KKoovalsky/Jeff/README.md

# **J**ungles' Guitar **Eff**ect :guitar: :musical_score: :notes: 

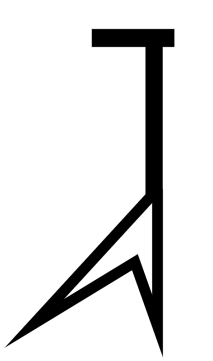
[picture p1: docs/diagrams/jeff_logo_white_background_small.drawio.png]
Jeff Logo


[Project main page](https://kkoovalsky.github.io/Jeff/)

The repository contains both the [hardware](hardware) and the [firmware](firmware). Check out the corresponding
directories for details.
