KKoovalsky/Jeff/firmware/scripts/hard_clipped_sine_dfts/hard_clipped_sine_dft_4000_100000_0.1_5.png

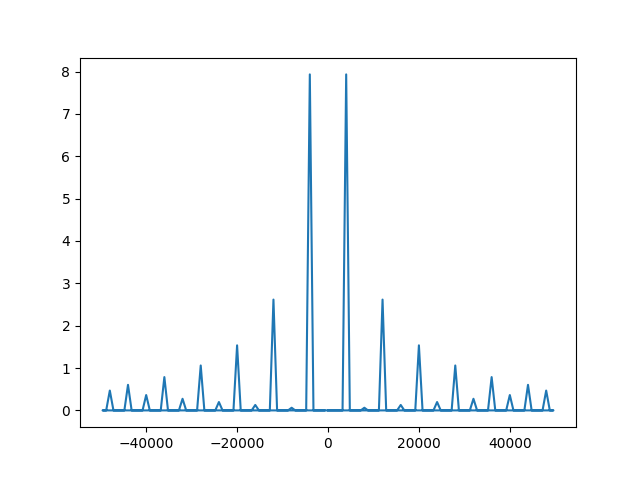
firmware/scripts/hard_clipped_sine_dfts/hard_clipped_sine_dft_4000_100000_0.1_5.png
