KKoovalsky/Jeff/firmware/scripts/hard_clipped_sine_dfts/hard_clipped_sine_dft_8000_100000_0.8_5.png

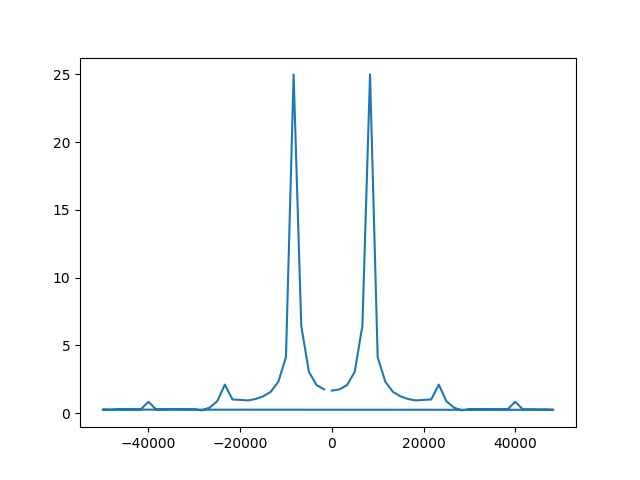
firmware/scripts/hard_clipped_sine_dfts/hard_clipped_sine_dft_8000_100000_0.8_5.png
