KKoovalsky/Jeff/firmware/scripts/hard_clipped_sine_dfts/hard_clipped_sine_dft_16000_100000_0.4_5.png

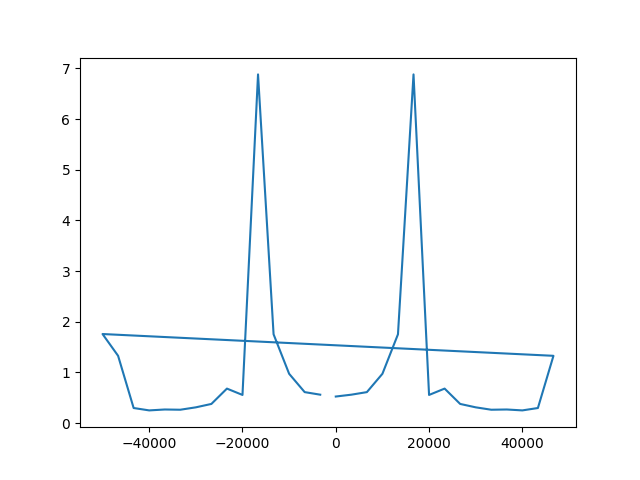
firmware/scripts/hard_clipped_sine_dfts/hard_clipped_sine_dft_16000_100000_0.4_5.png
