KKoovalsky/Jeff/firmware/device/cube/Jeff/Jeff.ioc

Mcu.UserName=STM32L432KCUx
PA0.GPIO_Label=ADC1_IN5_A0
PA0.Signal=ADCx_IN5
PA12.GPIO_Label=BUTTON0
PA12.Signal=GPIO_Input
PA2.GPIO_Label=LPUART1_TX_A7
PA2.Signal=LPUART1_TX
PA3.Signal=LPUART1_RX
PA4.GPIO_Label=DAC1_OUT1_A3
PA4.Signal=COMP_DAC11_group
PA6.GPIO_Label=TIM16_CH1_A5
PA6.Signal=S_TIM16_CH1
