KKoovalsky/Jeff/(commit log)

2021-12-06 Implement hard clipping and showing samples
2021-12-07 Print logs
2021-12-07 Move samples to 'samples' dir
2021-12-07 Generate code for STM32L432KC
    This is basic setup with:
    * FreeRTOS enabled
    * Debug LPUART enabled
    * 80 MHz clock
2021-12-07 Copy initial device build from Aura project
    Aura can be found here: https://github.com/KKoovalsky/AuraFW
2021-12-09 Add empty ThreadedAudioSampler
2021-12-09 Add outline test file for ThreadedAudioSampler
2021-12-10 Generate code with ADC and disabled LPUART Init call
    The LPUART init call was called inside main(). We call this on our own
    so there is no need to call it from the main().
2021-12-10 Add body of the basic test and set handler
    This tests doesn't work but compiles
    [threaded_audio_sampler.cpp, threaded_audio_sampler.hpp]
2021-12-10 Increase ADC conversion time
2021-12-10 Compile the new adc.c file
    It contains code related to ADC handling.
2021-12-10 Use LL library for the ADC
2021-12-10 Do not generate ADC1 interrupt handler - add own
    We will keep the interrupt handler in the same place it is used.
2021-12-13 Compile LL library files needed by adc.c
2021-12-13 Add base ThreadedAudioSampler Error
    The inheritors shall throw Errors which inherit from that Error.
2021-12-13 Implement ThreadedAudioSampler::Error
    The error (exception) message, passed to the constructor, will be
    prefixed with the name of the module.
    [threaded_audio_sampler.cpp, threaded_audio_sampler.hpp]
2021-12-13 Initially implement ADC1 interrupt handler
    This is taken from:
    STM32Cube_FW_L4_V1.17.0/Projects/NUCLEO-L496ZG/Examples_LL/ADC/ADC_SingleConversion_TriggerSW_IT
    I changed the code from the interupt handler a little bit, to expect End
    Of Sequence flag to be set, since this is how I configured the SW via
    CubeMX.
    There is a global static function handler added, called
    adc1_interrupt_handler, that can be used by the singleton to run some
    custom code. The custom code is called from the interrupt if it is
    initialized.
2021-12-13 Calibrate, activate and enable ADC
    This is a bit refactored code from the example:
    STM32Cube_FW_L4_V1.17.0/Projects/NUCLEO-L496ZG/Examples_LL/ADC/ADC_ContinuousConversion_TriggerSW_Init
    This is not yet tested.
    After running this code the ADC shall perform continuous conversions.
2021-12-13 Implement handling new sample
    The handler will be used when a new sample arrives. It converts the new
    sample and calls the external handler, set by
    set_on_sample_received_handler().
    The handler converts a raw sample according to voltage levels.
2021-12-13 Handle new samples from thread
    An Active object is used when new samples arrive. The
    adc1_interrupt_handler is called to push new raw sample to the message
    pump. Then the Active object will call the handler passed to it when
    constructing. The handler calls handle_new_sample().
    This makes the ISR handler possibly short and all the other handling is
    done from the task context.
    [threaded_audio_sampler.cpp, threaded_audio_sampler.hpp]
2021-12-14 Increase global FreeRTOS heap, default task stack size
    Because of the too low stack size of the default task the app crashed
    when switching context.
    [Jeff.ioc]
2021-12-14 Change Cube setting to wait for EOC instead of EOS
    This doesn't affect code, what is weird.
    [Jeff.ioc]
2021-12-14 Delay after ADC calibration
    If Enable function is called immediately after calibration, then we
    shall delay, according to the documentation and the examples, e.g.:
    STM32Cube_FW_L4_V1.17.0/Projects/NUCLEO-L496ZG/Examples_LL/ADC/ADC_ContinuousConversion_TriggerSW_Init/Src/main.c
    line 562
2021-12-14 Enable End Of Conversion ADC interrupt
2021-12-14 Implement test for ADC sampling frequency accuracy
    This test fails at this moment.
2021-12-14 Use fixed inserting to queue from ISR
2021-12-14 Add TODOs for ADC cleanup
2021-12-15 Handle samples in batches
    This introduces a little bit of coupling. Because of that the samples
    come quite frequently, we perform such scenario:
    1. ADC1 interrupt sends a sample to a queue.
    2. Queue is unlocked so a context switch may happen.
    3. Corresponding handler is called for a new sample.
    For each new sample a context switch may happen, what takes a lots of
    time. This means that we have to decrease the number of context
    switches. This is done by supplying the samples to the handler in
    batches. I guess we can use ADC with DMA for that.
    By introducing coupling I mean that the interface is forced to be
    defined basing on the details. On the other hand it is OK to define such
    an interfac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
2021-12-17 Generate code with DMA connected to ADC
    This enables DMA working with ADC from CubeMX. This is not utilized yet.
2021-12-17 Disable ADC interrupt
    We use batch DMA interrupt instead.
2021-12-17 Invoke batch handler on DMA interrupt
    This turns from using ADC interrupt on single sample received to use DMA
    interrupt, which is invoked when a batch of samples is sampled.
    The DMA is configured to store samples into internal raw_sample_buffer.
    The DMA interrupt is configured to trigger when the entire buffer is
    filled. Then send_new_batch_of_samples_to_active() is invoked from the
    interrupt handler. The interrupt handler can access this private method
    because there is a singleton_pointer. singleton_pointer is a pointer to
    the instance created with a constructor. Only one instance of
    ThreadedAudioSampler can be created at a time. The DMA interrupt handler
    is friend to the ThreadedAudioSam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
2021-12-17 Add custom HardFault_Handler
    By inspecting 'frame' pointer from GDB, one can find out some details
    about the hard fault.
    Currently I'm struggling with HardFaults generated when sending objects
    from the DMA interrupt to the Active.
2021-12-17 Increase heap size by 4kB
    I couldn't increase more, because in the Debug build the app crashed at
    the beginning. This might be related to overlapping sections in RAM.
    [Jeff.ioc]
2021-12-17 Increase thread stack size
    Just to be sure.
2021-12-17 Implement tearing down ThreadedAudioSampler
2021-12-17 Decrease test thread stack size
    The stack size is passed in words, not in bytes, as I thought before. 4
    kB of stack size is much and enough.
2021-12-17 Fix ADC clock to be more or less 48 kHz
    [Jeff.ioc]
2021-12-17 Fix counting received samples from the test
2021-12-17 Switch to custom event-based synchronization
    The ThreadedAudioSampler used jungles::freertos::active before. This is
    wrong, because it used FreeRTOS ISR API to quit the thread.
    Active is good when using messaging between multiple threads, or when
    deputing job for later and splitting the tasks. Here we use DMA with
    specific timely requirements. Active introduces lots of overhead for
    this solution. Custom Event-based approach is much better here.
    The new approach works in such a way:
    1. DMA will trigger interrupt on half transfer and full transfer.
    2. The raw buffer is twice the size of the converted sample buffer.
    3. When half transfer IT occurs the first half of the raw sample
    buffer is t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
    [threaded_audio_sampler.cpp, threaded_audio_sampler.hpp]
2021-12-17 Remove non-testable test
    We can't really test the stability of the sampling frequency, because
    we should test here whether the clock is stable.
    The samples come for sure not in orderly matter because we use RTOS,
    which may affect timings.
    This doesn't mean that the samples received have jitter because of
    RTOS. We simply perform calculation non-deterministically.
2021-12-18 Fix batch of samples to be std::vector<int>
    This fixes the AudioSampler Interface to expect any type in the handler.
    This is much better because the type used may be anything: a pair of
    iterators, a const reference to some container.
    We use std::vector<int> passed to the handler by value.
    This is much better, because we can easily move around the vector.
    [threaded_audio_sampler.cpp, threaded_audio_sampler.hpp]
2021-12-19 Delay before disabling
    This is needed, because in the Release build this has failed.
    The error was that the test:
    test_multiple_instances_can_be_run_one_after_another() failed (hanged),
    because the previous instance was not properly stopped.
    After the first instance was created, the second instance didn't
    generate any interrupt, due to inproper disabling of ADC.
    [threaded_audio_sampler.cpp]
2021-12-19 Generate code for TIM6 triggered ADC
    With this commit we generated code for ADC triggered by the external
    TIM6 Update Event. The frequency of Update Events is set to more or less
    44100 Hz:
    80000000 / 907 / 2 = 44101,43329658213891951488
    Thanks to it the TIM6 will drive sampling frequency. It was impossible
    to have such a frequency using only ADC settings.
2021-12-19 Start the TIM6 according to schedule
    This will drive ADC using external TIM6. The sampling frequency will be
    around 44.1 kHz.
2021-12-19 Implement Singleton properly
    When the second instance of ThreadedAudioSampler is created it throws.
    There was an error, because the jungles::freertos::thread had a bug,
    which showed up when the thread was destructed without being started.
    This is fixed with the new version of the library.
2021-12-19 Alias malloc() and free() to FreeRTOS equivalents
    To make it thread-safe.
2021-12-20 Generate code: GPIO HAL to LL; support button
    We have switched for GPIO from HAL to LL, because basically we would
    like to switch from HAL to LL for any component.
    This switch was by the way for generation of the code for an input pin
    which will be used for input button.
2021-12-20 Initial implementation of button handling
    This implements and tests Button, in semi-automatic way (the developer
    is asked to press the button).
    I have soldered a debouncing hardware from this blog post:
    https://hackaday.com/2015/12/09/embed-with-elliot-debounce-your-noisy-buttons-part-i/
    Exactly, this circuit:
    https://hackaday.com/wp-content/uploads/2015/11/debounce-sch.png
    The first tests passes.
    Others are not yet implemented.
2021-12-20 Fix button press detect when not released
    We didn't wait for the button to be released and because of that the
    tests have passed quickly after first button press. The first button
    press was detected as multiple. This is because we didn't wait for the
    button release.
    The second test is implemented and passes.
    [button.cpp]
2022-01-04 Switch to float for samples
    Since this commit the samples will be in range <-1;1> instead of
    <INT_MIN;INT_MAX>. This is easier for computation and prevents from
    overflows.
    [threaded_audio_sampler.cpp, threaded_audio_sampler.hpp]
2022-01-04 Test input sine sampling
    This adds semi-automatic tests which test whether input sine wave is
    properly sampled. The tests check against 100 Hz, 1 kHz, 10 kHz and 20
    kHz.
    The tests work in such a way that it is expected to provide the
    corresponding sine wave to the input pin PA0 (A0 STM32L432KC Nucleo
    pin). The amplitude shall be 1.6V, DC offset 1.6V. Then the sine wave is
    compared against a pattern and cross correlation function is calculated.
    At this stage the tests are quite unstable. Sometimes they show that the
    correlation factor is almost 1 (or -1). But every second test it shows
    much smaller value. It may depend on the function generator I use, which
    is so-so stable (GW GFG-8019G). E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
2022-01-07 Switch to FFT based harmonic comparison
    We abandon cross-correlation function based comparison, because it is
    better for populations and sets, not good for signals. We use FFT
    instead.
    Because of that the Q DSP library (used for generating sine wave which
    was the signal pattern) and CPP Utils library (implementing
    cross-correlation function) are no longer needed.
    The comparison works like that:
    * Compute FTT and harmonic magnitudes.
    * For the specific harmonic find an index in the FFT.
    * Get power of the harmonic, by adding the magnitude of the
    corresponding FFT sample and the magnitude of the FFT samples on the
    left and right (get_sum_around())
    * Get power of the noise, which is the sum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
2022-01-11 Add initial DAC implementation
    It doesn't work yet, but compiles. We will use it to synthesize the
    sampled signal with applied guitar effect.
2022-01-11 Generate code for DAC with CubeMX
    Low-level code with DAC is enabled, where:
    * DMA is enabled to provide buffered data to DAC
    * No DMA ISR routine is generated - to be defined.
    * TIM6 is used to sample the data. The same Timer is used for ADC, so it
    means that the input frequency will be the same as output frequency.
2022-01-21 Add interface and implementer for sampling timer
    This will be used by both the ADC and DAC, to generate the same sampling
    frequency in both modules. The timer will be have to implement an use
    count, similar to "reference count", when using start() and stop(). This
    is a must, because otherwise the timer could be stopped when it is still
    needed by the other module.
    The ADC doesn't use the interface yet, thus it is a TODO.
2022-01-21 Implement basic audio DAC
    This only implements the module to pass the tests in
    test_audio_dac_basic.cpp. The sine wave generation is not yet
    implemented.
    The implementation is a copy of the implementation within the
    ThreadedAudioSampler. The principle of operation is similar. We use DMA
    to update the underlying raw buffer from the thread code. The raw buffer
    is twice the size of the buffer with samples, which are obtained using
    the Handler. After each half of the buffer transferred using DMA to DAC,
    we ask the Handler for new samples and copy it to the just-updated half,
    to give time for conversion, thus preventing from overwritting. This is
    hard-real-time task, so the conversion should be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
2022-01-25 Switch to pointer to array for compat. with DAC
    Since the buffer will be passed from the sampler to the DAC, then we
    need to have the same types for both modules.
2022-01-25 Get rid of finisher semaphore and use join() instead
    The semaphore was not needed because we can simply use join() on the
    thread.
2022-01-25 Use SamplingTriggerTimer within the audio sampler
    The same timer is used by the DAC and the audio sampler to provide
    synchronization. This is why we use the same interface in both modules.
2022-01-26 Implement and test AudioChain
    The AudioChain represents the chain of the signal:
    sampler -> guitar effect -> DAC
    Thanks to this logic module, we can develop those three modules in
    separation.
2022-01-27 Test input signal is outputted with no change
    I have tested it and I can see the output being the duplicate of the
    input. The accuracy is not so high. The output has shape of stairs,
    because of digital DAC.
    The setup is:
    - connect function generator to A0, generate sine wave, DC offset 1.6V
    amplitude 1.6V
    - connect oscilloscope to A3, and see the duplicated output signal
2022-02-01 Initial impl of BasicWindowedDistortionWithMemory
    This is Distortion implementation by windows, with memory, which stores
    the previous batch of samples. It works in such a way, that for each
    sample a absolute maximum is found in a window. If current sample has
    i'th index and window size is W then the window spans from sample
    'i - W' excluded to 'i' included. For that window a threshold is
    calculated basing on the absolute maximum value. If the current sample's
    absolute value is above the threshold, then it is clamped to the
    [- window threshold] or [+ window threshold].
    The implementation is initial because it is not fully tested and some
    improvements and refactorings will be made.
2022-02-01 Switch to data driven tests
    There will be multiple cases, so it is better to switch to data driven
    tests.
2022-02-02 Add benchmark for distortion
    It will be used like that:
    ./tests/host/jeff_host_tests [!benchmark]
    I will apply refactoring to the guitar effect, thus the benchmark will
    be really helpful in such case.
2022-02-02 Optimize distortion
    The optimization introduces:
    1. Calculating absolute values once for each batch...
    2. ...Then we can store the previous batch's absolute values, and not
    recalculate it.
    Previously, absolute values were calculated each time an absolute maximum
    was searched. Now we use one more container (so regarding the data,
    there is no optimization, but the opposite - we will use more data) to
    store the calculated absolute values for the current batch and then
    we store it as the previous absolute values for the next call to
    apply().
    According to benchmarks, this improves significantly:
    -------------------------------------------------------------------------------
    Basic windo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
2022-02-02 Pretty print benchmark
2022-02-07 Add global audio chain configuration
    This will be used by the ADC and DAC implementers, and by GuitarEffect
    implementers, since the type compatibility between the implementers
    (interfaces as source) is a must.
2022-02-07 Use global BatchOfSamples
    Since all the implementers have to be type compatible, then it's good to
    have a single file with the current configuration of the audio chain.
    The implementers, I have mentioned, are all the interfaces from the
    AudioChain.
    We simplify the usage of BatchOfSamples to treat is as a container.
2022-02-07 Add JeffAppWrapper which wraps the app
    This is a wrapper which allows to create apps only by inserting the
    guitar effect, thus applying DRY by not instatiating DAC and ADC
    implementers for each application.
2022-02-07 UNTESTED: Add distortion app
    This is basic distortion app which is not tested at this stage.
2022-02-07 Switch to JeffAppWrapper in the audio chain
2022-02-07 Make distortion_app a device executable
2022-02-08 Generate code for filter clock generation
    The post-DAC filter and the anti-aliasing filter are SCF filters. They
    need clock at one of the inputs to set the cutoff frequency, which is
    100:1. Thus to set 20 kHz pass-band we have to generate 2 MHz clock.
    This generates code which allows to generate clock at PA6 pin, using
    TIM16 PWM. This is not used, thus not tested yet.
2022-02-08 Decrease Tick interrupt priority
    After using TIM16 CubeMX automatically changed the interrupt priority. I
    don't know yet what is the impact of it.
2022-02-08 Not working: Add filter cutoff frequency setter clock
    This doesn't work yet. This adds new test which checks whether the class
    is able to produce the clock. At this stage it is not.
    I will investigate that further.
    I checked the code agains the example:
    STM32Cube_FW_L4_V1.17.0/Projects/NUCLEO-L496ZG/Examples_LL/TIM/TIM_PWMOutput_Init
    and it seems almost identical. The problem may lie in the SB16/SB18
    jumpers on the nucleo board.
    [filter_cutoff_setter_clock.cpp, filter_cutoff_setter_clock.hpp]
2022-02-08 Fix clock to generate 2 Mhz, 50% duty cycle
    Previous configuration was wrong. It gave me around 2,6 MHz frequency
    and 33% duty cycle.
    [Jeff.ioc]
2022-02-08 Fix clock generation by enabling outputs
    Without the call to *EnableAllOutputs() no output was generated at the
    pin A5. This fixes 2MHz clock generation.
    [filter_cutoff_setter_clock.cpp]
2022-02-08 Document filter cutoff setter clock test
2022-02-10 Run filter cutoff frequency setter from any app
    This enables running the filter cutoff frequency setter from any app
    that uses the wrapper.
2022-02-10 Add layout for benchmark timer
    This are shallow tests and implementation for future filling (doesn't
    work yet).
2022-02-10 Generate code with CubeMX for benchmark timer TIM7
    We will use TIM7 to count microseconds for the benchmark timer.
2022-02-10 Implement benchmark timer
2022-02-10 Document benchmark timer tests
2022-02-11 Fix overflow calculation for benchmark_timer
    The problems were that:
    1. The max_hardware_timer_counter_value was initialized before call to
    MX_TIM7_Init, where the AutoReload register is initialized, thus we
    initialized max_hardware_timer_counter_value with 0 always. At the stage
    of initializer list being called, the TIM7 was not initialized yet.
    2. The actual "period" of the timer is AutoReload + 1, because the timer
    counts from 0.
2022-02-11 Benchmark distortion on the device
    This adds test which checks how much time does it take for
    BasicWindowedDistortionWithMemory to apply the effect.
    Results are:
    INFO: Distortion apply() execution times: max: 572, min: 564, average: 567.019
    Which means that, taking into consideration that we have window with 64
    samples converted by ADC (or DAC) with 44100 Hz frequency, gives around
    1450 us to sample a window. It means that we have 1450 us between each
    transfer. Taking into account RTOS context switching and signal
    adaptation calculations within ADC and DAC we have around 1000 us for
    the guitar effect to apply the effect.
    Around 570 us seems cool.
    Whether the 500 us margin for RTOS c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
2022-02-14 Initially add tracing
    This creates an interface which allows to trace events within the
    firmware. Currently the audio chain itself uses it, but we will use it
    in the ADC and DAC implementations as well.
    The idea is to see how much time does each stage take within the
    firmware itself, instead of checking it in separation. The OS itself
    and context switching adds some overhead, so we need to take that into
    calculation as well.
    A RAII class has been added, which allows to capture events at the
    beginning of the scope and at the end of the scope.
    First implementation is dummy, so no capturing is implemented at this
    stage.
2022-02-14 Add event tracing to ADC
2022-02-17 Implement event_periodic_dumper
    This EventPeriodicDumper implements EventTracer, in a way that the
    captured events are dumped with specified period.
    RingBuffer dependency has been added, because the events are stored in a
    circular buffer. When the dumping period is reached all the events from
    the ring buffer are dumped, thus effectively only the last events are
    dumped. The number of the events dumped are equal to the RingBuffer
    size, which is 256 currently.
    I also updated the JunglesOsHelpers dependency to make use of
    mutex::try_lock() which is implemented in the newer version.
2022-02-17 Allow to dump traced events in any app
    If the app implementation uses the wrapper, then the traced events can
    be dumped over serial according to JEFF_TRACE_AND_DUMP_EVENTS CMake
    CACHE variable.
2022-02-17 Benchmark various containers on the device
    For constructing and moving around, I was curious which of the
    approaches is most time-effective:
    * std::unique_ptr<std::array<unsigned, Size>>
    * std::array<unsigned, Size>
    * std::vector<unsigned>{Size>
    And it turns out that the former is the most efficient timewise,
    according to the logs from the benchmark:
    INFO: Performing construction and then move-construction benchmark, for 1024 and container size: 1024
    INFO: std::unique_ptr<std::array<unsigned, 1024>> duration: 49336
    INFO: std::array<unsigned, 1024> duration: 65370
    INFO: std::vector<unsigned> with size: 1024, duration: 50029
    INFO: BatchOfSamplesTemplate<1024> duration: 4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
2022-02-22 Fix compilation issues with missing implementer
    We have introduced the event tracer to the audio chain, but I forgot to
    apply those changes to the host tests.
2022-02-23 Initial hardware design schematic
    Contains only buffer amp and DC offset applier.
    [DcOffsetApplier.sch, DcOffsetRemover.sch, GuitarInputBuffer.sch, Jeff.kicad_pcb, Jeff.sch]
2022-02-24 Add Analog Front End schematic, without miscs
    The miscellanuous things I mean are the half-VCC splitter, VDD line,
    negative voltage maker.
    [AudioLowPassFilter.sch, DcOffsetApplier.sch, DcOffsetRemover.sch, GuitarInputBuffer.sch, Jeff.sch]
2022-02-24 Add negative voltage generator schematic
    This also connects the negative voltage to the analog front end.
    [AudioLowPassFilter.sch, DcOffsetApplier.sch, DcOffsetRemover.sch, GuitarInputBuffer.sch, Jeff.sch, NegativeVoltageGenerator.sch]
2022-02-24 Add VDD-half splitter
    [AudioLowPassFilter.sch, DcOffsetApplier.sch, DcOffsetRemover.sch, GuitarInputBuffer.sch, Jeff.sch, NegativeVoltageGenerator.sch, VddHalfSplitter.sch]
2022-02-24 Add DSP block and connect to analog front end
    The DSP block contains STM32L432KC nucleo board, which is also added
    with this commit, as a library. The output of the analog front end has
    been connected to the CPU as well as the cutoff frequency setter clock.
    [Jeff.sch]
2022-02-24 Add Post-DAC stage schematic
    This includes the low pass filter, which is the same like the one in the
    Front End, the offset remover circuit, all the connections to DSP stage,
    which is the DAC output and the filter cutoff setter clock.
    [AudioLowPassFilter.sch, DcOffsetApplier.sch, DcOffsetRemover.sch, GuitarInputBuffer.sch, Jeff.sch, NegativeVoltageGenerator.sch, VddHalfSplitter.sch]
2022-02-25 Rename LP filter in AFE
    [AudioLowPassFilter.sch, Jeff.sch]
2022-02-25 Document post-DAC stage and miscellaneous
2022-03-12 Link to freertos only for device build
    We will use JunglesOsHelpers on the host side, but we will only use the
    native utilities, thus we can't link to freertos for the host build.
2022-03-12 Rework AudioChain to be run in main context
    With run() and stop() we can run the AudioChain from the current thread,
    decreasing number of threads needed to run the app. Since the
    AudioSampler and the AudioDac are awaitables, they could also benefit
    from that and not run their own contexts, from which they would have to
    call the callbacks, as in the previous solution.
    Design-wise we will decrease the number of threads by 2, because there
    will be neither ThreadedAudioSampler, nor ThreadedAudioDac, since they
    will raise events directly to the overriden *await_() function.
2022-03-12 Simplify AudioChain
    Now the AudioChain has seriously only one responsibility, which is
    chaining the Audio signal from ADC, through GuitarEffect to DAC.
    This allows to separate the problem of running and stopping to another
    module. The tests are real simple now as well. We don't need to use
    std::thread and any time-related operations at all.
2022-03-12 Adapt ThreadedAudioSampler to new interface
    It's name is no longer valid, because there is no thread involved, so
    TODO is to rename it.
    Since this commit the class is awaitable, according to the AudioChain
    requirements.
    The code didn't change a lot regarding the logic. The half-transfer
    events and full-transfer events are transfered to the await_samples().
    We could drop the quit event, since there is no thread to quit.
    The tests pass, but the problem is that when they fail, the objects are
    not properly destructed. This must be fixed.
    [threaded_audio_sampler.cpp, threaded_audio_sampler.hpp]
2022-03-12 Better assertions for received samples
2022-03-12 Adapt sample sine test to new AudioSampler interface
    Those tests are verified and do work.
2022-03-12 Initial compile-time fixes for ThreadedAudioDac
    This doesn't implement the new interface yet.
2022-03-12 Fix test hanging when failure
    Because of that the Unity test framework uses `setjmp` and `longjmp` the
    destructors are not called when the tests fail. This is really annoying,
    because there will be some crash on the way because of that, since
    something was not cleaned up, dangling references arise, and similar
    issues.
    Disabling this within Unity will return control to the test even when
    the test fails.
2022-03-15 Use non-default-initialized BatchOfSamples
    The benchmark didn't have a lot of value when the BatchOfSamples
    contained only zeros.
    The generated samples are scrapped from AudioDacWithDma, for input sine
    wave with frequency 1.34 kHz. This means that the
    generate_batch_of_samples() will return a snapshot of 1.34 kHz sine wave
    sampled with 44.1 kHz.
2022-03-15 Optimize distortion
    The previous solution was not well optimized, because for each window a
    maximum was searched over the whole window.
    Now we keep track of the maximum within the window. The window moves one
    sample to the right always. Thanks to it we can see if the new sample
    (which jumped to the window because of the right-shift) is bigger than
    the current absolute maximum. If it's true, then this sample is the new
    current absolute maximum. We also check whether the current absolute
    maximum didn't drop out of the window (was the max-left sample in the
    window). If it did, we have to find a new maximum over the entire
    window.
