KKoovalsky/Jeff/(notices)

Notices in the files:
firmware/device/cube/Jeff/Core/Inc/main.h:
© Copyright (c) 2021 STMicroelectronics.
All rights reserved.
This software component is licensed by ST under Ultimate Liberty license
(C) COPYRIGHT STMicroelectronics *****END OF FILE
